Masonry11/JetRacer-Soccer-League-Year-3/Deliverables/Biweekly Reports/Biweekly_Report_Apr13.pptx

Overview

JetRacer Soccer
Jarod Marshel, Casey Rittenhouse, Arjun Simha, Mason Kang, K Gupta, Julie Ham, Cooper Ritter

Overall Project Deliverable | Progress
Basic Movement | Done
Image recognition | Done
New sensor implementation | In progress
Object following/Ball Striking | In progress
Co-op and Versus | Not started
Github with documentation | In progress
Summary and report | In progress

Project is On Schedule

Overall Concept:

New Sensor

Gantt Chart/Schedule

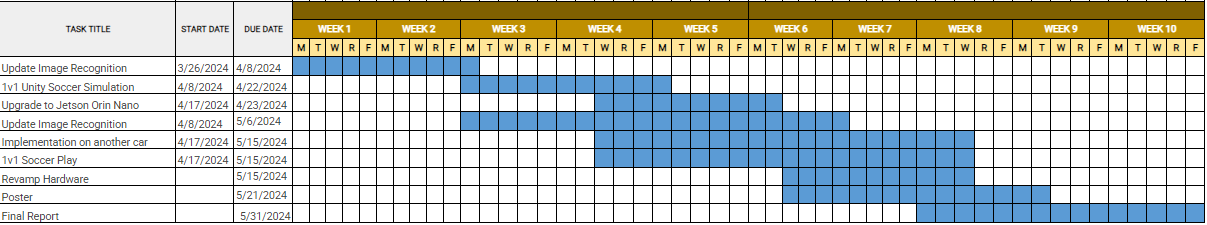
[picture p1: figure]

## Slide 2

Short-Term

JetRacer Soccer
Jarod Marshel, Casey Rittenhouse, Arjun Simha, Mason Kang, K Gupta, Julie Ham, Cooper Ritter

Previous Meeting Action Items:

Item | Description | Owner | Target Date | Status
1 | Build field for cars | Jarod | Feb 19 | Done
2 | Unity soccer simulation training | Mason | Jan 31 | Done
3 | Object following | Everyone | Mar 8 | Done
4 | Implement new sensor onto car | Everyone | Mar 11 | Done
5 | Preliminary Design Review | Everyone | Mar 12 | Done
6 | Retrain Object Detection | CV team | April 15 | In Progress
7 | 1v1 Soccer | Everyone | May 1 | Not started

Item | Description | Owner | Target Date | Status
1 | Retrain Object Detection | CV team | April 15 | In Progress
2 | 1v1 Soccer Logic | Not assigned | May 1 | Not started
3 | Set up software on cars | Casey | April 20 | In Progress
4
5

Significant Roadblocks/ Non-developing Items:

Jetson Orin
ZED SDK version conflict

Request for teaching staff:

Biweekly Action Items:

Budget:

Total Proposed | Plan to Date | Used to Date | Used Vs Plan
$3500 USD | $1450 USD | $650 USD | +$1400 USD

Apr | | | | | | | | | | Feb
11 | | | | | 16 | | | | | 21

Short Term Schedule:

Train new YOLOv8

Start upgrade to Orin

## Team Progress

## ROS (Casey and Cooper and Arjun)

JetRacer Soccer
Jarod Marshel, Casey Rittenhouse, Arjun Simha, Mason Kang, K Gupta, Julie Ham, Cooper Ritter

Previous Work:
- Determined Jetson Orin is necessary to complete desired function
- Planned versions for all necessary packages to ensure compatibility
- Looked into Docker and JetPack

Future Work:
- Purchase Jetson Orin
- Migrate current work to the Orin
- Continue to improve ROS structure
- Install Zed SDK
- Configure Docker and JetPack

## Computer Vision (K and Julie and Jarod)

JetRacer Soccer
Jarod Marshel, Casey Rittenhouse, Arjun Simha, Mason Kang, K Gupta, Julie Ham, Cooper Ritter

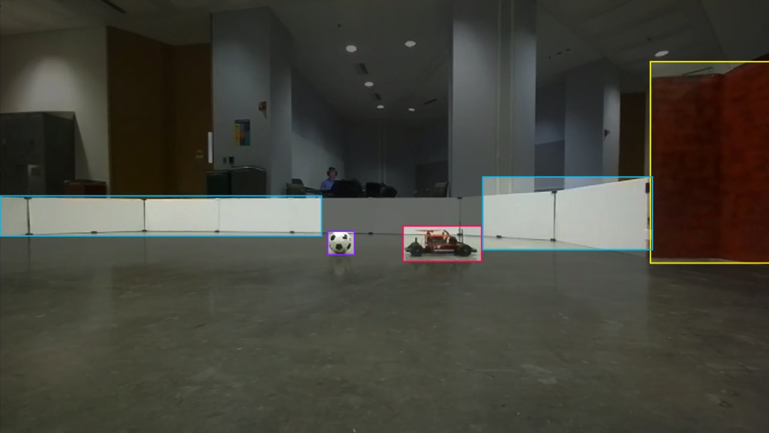
[picture p2: figure]

Previous Work:
- Annotated new dataset
- Started training weights for YOLOv8

Future Work:
- Run a YOLOv8 detection program
- Work with ROS team to set up publisher and subscriber for steering servo and ball following

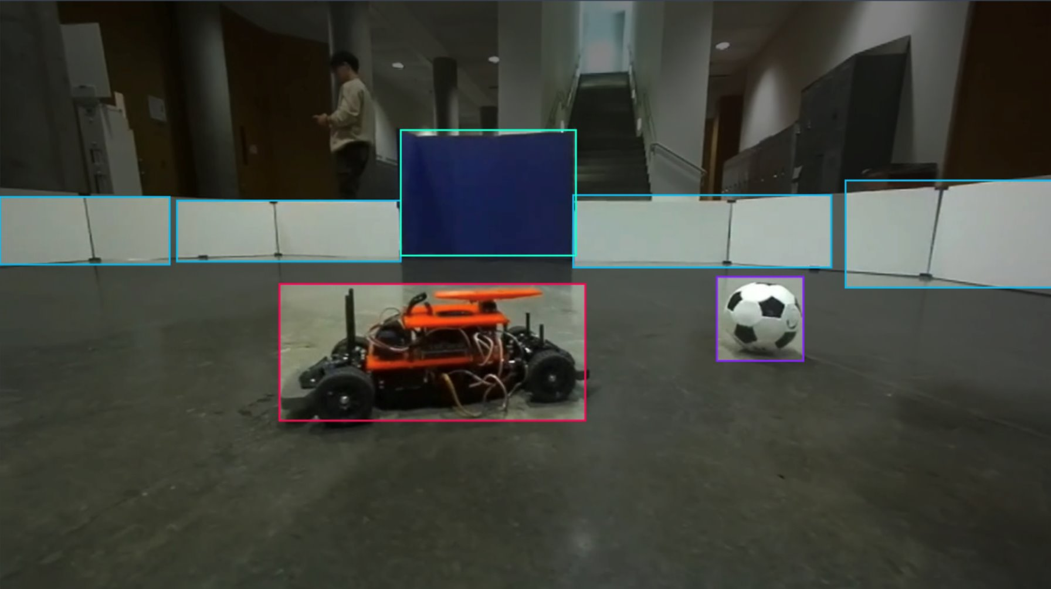
[picture p3: figure]

## Unity (Mason)

JetRacer Soccer
Jarod Marshel, Casey Rittenhouse, Arjun Simha, Mason Kang, K Gupta, Julie Ham, Cooper Ritter

Previous Work:
- Create a 3rd year repo for the JetRacer project.
- Optimize the Unity simulation as much as possible.

Future Work:
- Further document the GitHub page.
- Gather details about the Unity training and use them to prepare for the winter presentation.
