Masonry11/JetRacer-Soccer-League-Year-3/Deliverables/Biweekly Reports/Biweekly_Report_Apr27.pptx

Overview

JetRacer Soccer
Jarod Marshel, Casey Rittenhouse, Arjun Simha, Mason Kang, K Gupta, Julie Ham, Cooper Ritter

Overall Project Deliverable | Progress
Basic Movement | Done
Image recognition | Done
New sensor implementation | In progress
Object following/Ball Striking | In progress
Versus and Strategy | In progress
Github with documentation | In progress
Summary and report | In progress

Project is On Schedule

Overall Concept:

New Sensor

Gantt Chart/Schedule

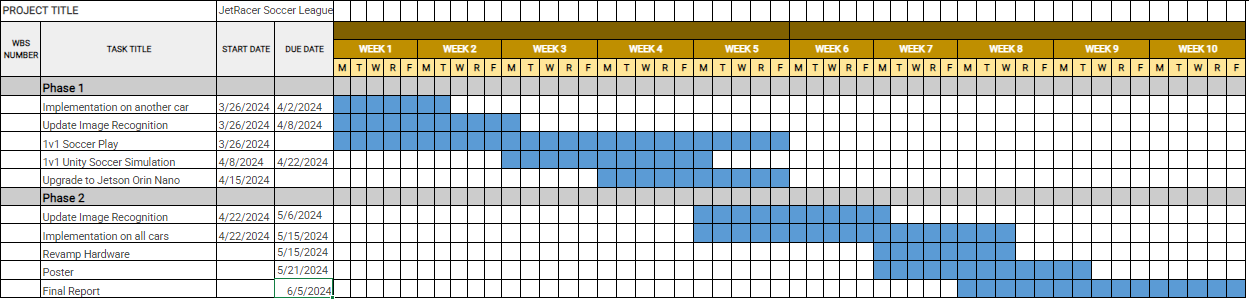
[picture p4: figure]

## Slide 2

Short-Term

JetRacer Soccer
Jarod Marshel, Casey Rittenhouse, Arjun Simha, Mason Kang, K Gupta, Julie Ham, Cooper Ritter

Previous Meeting Action Items:

Item | Description | Owner | Target Date | Status
1 | Build field for cars | Jarod | Feb 19 | Done
2 | Unity soccer simulation training | Mason | Jan 31 | Done
3 | Object following | Everyone | Mar 8 | Done
4 | Implement new sensor onto car | Everyone | Mar 11 | Done
5 | Preliminary Design Review | Everyone | Mar 12 | Done
6 | Retrain Object Detection | CV team | April 15 | In Progress
7 | 1v1 Soccer | Everyone | May 1 | Not started

Item | Description | Owner | Target Date | Status
1 | Retrain Object Detection | CV team | April 15 | In Progress
2 | 1v1 Soccer Logic | Not assigned | May 1 | Not started
3 | Set up software on cars | Casey | April 20 | In Progress
4
5

Significant Roadblocks/ Non-developing Items:

Jetson Orin conflict
ZED SDK version conflict

Request for teaching staff:

Biweekly Action Items:

Budget:

Total Proposed | Plan to Date | Used to Date | Used Vs Plan
$3500 USD | $1450 USD | $650 USD | +$1400 USD

Apr - May | | | | | | | | | | Feb
21 | | | | | 28 | | | | | 5

Short Term Schedule:

Test new YOLOV8

Start upgrade to Orin

## Team Progress

## ROS/Hardware (Cooper and Arjun)

JetRacer Soccer
Jarod Marshel, Casey Rittenhouse, Arjun Simha, Mason Kang, K Gupta, Julie Ham, Cooper Ritter

Previous Work:
- Integrated rospy with roscpp structure
- Got I2C communication (for servo control) working on Jetson
- Developed PID controller for ball tracking
- Fixed ZED calibration file issues

Future Work:
- Fine-tune ZED PID controller
  - Fix bugs
  - Improve tracking
- Implement search/scan function when ball is lost
- Print updated car parts

## CV/Image Recognition (K and Julie and Jarod)

JetRacer Soccer
Jarod Marshel, Casey Rittenhouse, Arjun Simha, Mason Kang, K Gupta, Julie Ham, Cooper Ritter


Previous Work:
- Issues running object detection with ZED on laptops- need to run on Jetson

Future Work:
- Update object recognition to include classification for blue car


## Software/Strategy (Casey and Mason)

JetRacer Soccer
Jarod Marshel, Casey Rittenhouse, Arjun Simha, Mason Kang, K Gupta, Julie Ham, Cooper Ritter

Previous Work:
- Worked on developing movement strategy
- Developed strategy for camera and steering movement
(Including basic 1v0 and ball intercepting strategy)
- Began migrating code from unity

Future Work:
- Continue to refine movement strategy
- Implement on car once hardware team is finished

## Team Roles

- Project Manager - Jarod
- Point of Contact - Arjun
- Budget Manager - Casey
- ROS/Hardware Team:
  - Cooper, Arjun,
- CV/Image Recognition Team:
  - K, Julie, Jarod
- Software/Strategy Team:
  - Casey, Mason
