Masonry11/JetRacer-Soccer-League-Year-3/Deliverables/Biweekly Reports/Biweekly_Report_Mar4.pptx

Overview

JetRacer Soccer
Jarod Marshel, Casey Rittenhouse, Arjun Simha, Mason Kang, K Gupta, Julie Ham, Cooper Ritter

Overall Project Deliverable | Progress
Basic Movement | Done
Image recognition | Done
New sensor implementation | In progress
Object following/Ball Striking | In progress
Co-op and Versus | Not started
Github with documentation | In progress
Summary and report | In progress

Project is On Schedule

Overall Concept:

New Sensor

Gantt Chart/Schedule

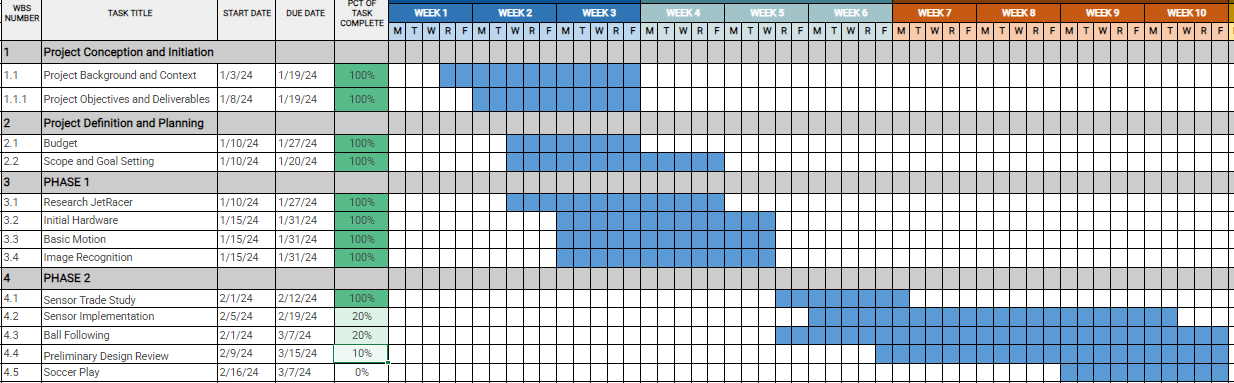
[picture p5: figure]

## Slide 2

Short-Term

JetRacer Soccer
Jarod Marshel, Casey Rittenhouse, Arjun Simha, Mason Kang, K Gupta, Julie Ham, Cooper Ritter

Previous Meeting Action Items:

Item | Description | Owner | Target Date | Status
1 | Build field for cars | Jarod | Feb 19 | Done
2 | Unity soccer simulation training | Mason | Jan 31 | Done
3 | Object following | Everyone | Mar 8 | In progress
4 | Implement new sensor onto car | Everyone | Mar 11 | In progress
5 | Preliminary Design Review | Everyone | Mar 12 | In progress
6
7

Item | Description | Owner | Target Date | Status
1 | Object following | Everyone | Mar 8 | In progress
2 | Preliminary Design Review | Everyone | Mar 12 | In progress
3 | Implement new sensor onto car | Everyone | Mar 11 | In progress
4
5

Significant Roadblocks/ Non-developing Items:

Biweekly Action Items:

Budget:

Total Proposed | Plan to Date | Used to Date | Used Vs Plan
$3500 USD | $0 USD | $0 USD | +/-$0 USD

March | | | | | | | | | | Feb
4 | | | | | 11 | 12

Short Term Schedule:

Request for teaching staff:

Get car to follow ball

Have presentation ready

## Team Progress

## ROS (Casey and Cooper)

JetRacer Soccer
Jarod Marshel, Casey Rittenhouse, Arjun Simha, Mason Kang, K Gupta, Julie Ham, Cooper Ritter

Previous Work:
- Established structure to control Zed servo
- Continued to tune movement
- Began converting ROS structure to Noetic
- Updated documentation to make ROS implementation more straightforward

Future Work:
- Work on Zed integration once CV team is ready
- Work on winter presentation and report

## LiDAR (Arjun and Jarod)

JetRacer Soccer
Jarod Marshel, Casey Rittenhouse, Arjun Simha, Mason Kang, K Gupta, Julie Ham, Cooper Ritter

Previous Work:
- Worked on putting together the winter quarter presentation documenting all of our progress and the future progress we will be working on in the spring quarter.
- Worked on putting together the design report for the winter quarter.

Future Work:
- Once ZED testing is done in winter quarter, we will work on putting together a docker container to combine all of the packages on one car to be put on the rest of the three cars.
- Need to fix up the other three cars and their parts, charge the batteries and controllers.
- Want to fully setup the full field in the ECE basement soon to see how it looks and test it with the cars and the soccer ball

## Computer Vision (K and Julie)

JetRacer Soccer
Jarod Marshel, Casey Rittenhouse, Arjun Simha, Mason Kang, K Gupta, Julie Ham, Cooper Ritter

Previous Work:
- Old camera does not work anymore – hardware issue?
  - gst_mini_object_set_qdata: assertion 'object != null' failed
  - Shift focus to ZED2
- Upgraded to Python3.8 (needed for YOLOv8)
- Trained weights for YOLOv8
- Reinstalled ZED SDK

Future Work:
- Run a YOLOv8 detection program
- Work with ROS team to set up publisher and subscriber for steering servo and ball following

## Unity (Mason)

JetRacer Soccer
Jarod Marshel, Casey Rittenhouse, Arjun Simha, Mason Kang, K Gupta, Julie Ham, Cooper Ritter

Previous Work:
- Create a 3rd year repo for the JetRacer project.
- Optimize the Unity simulation as much as possible.

Future Work:
- Furthur document the GitHub page.
- Gather details about the Unity training and use them to prepare for the winter presentation.
