Masonry11/JetRacer-Soccer-League-Year-3/Deliverables/Biweekly Reports/TA_Meet_Apr11.pptx

## Weekly Meeting 4/11/2024

JetRacer Soccer League

## Software Versions

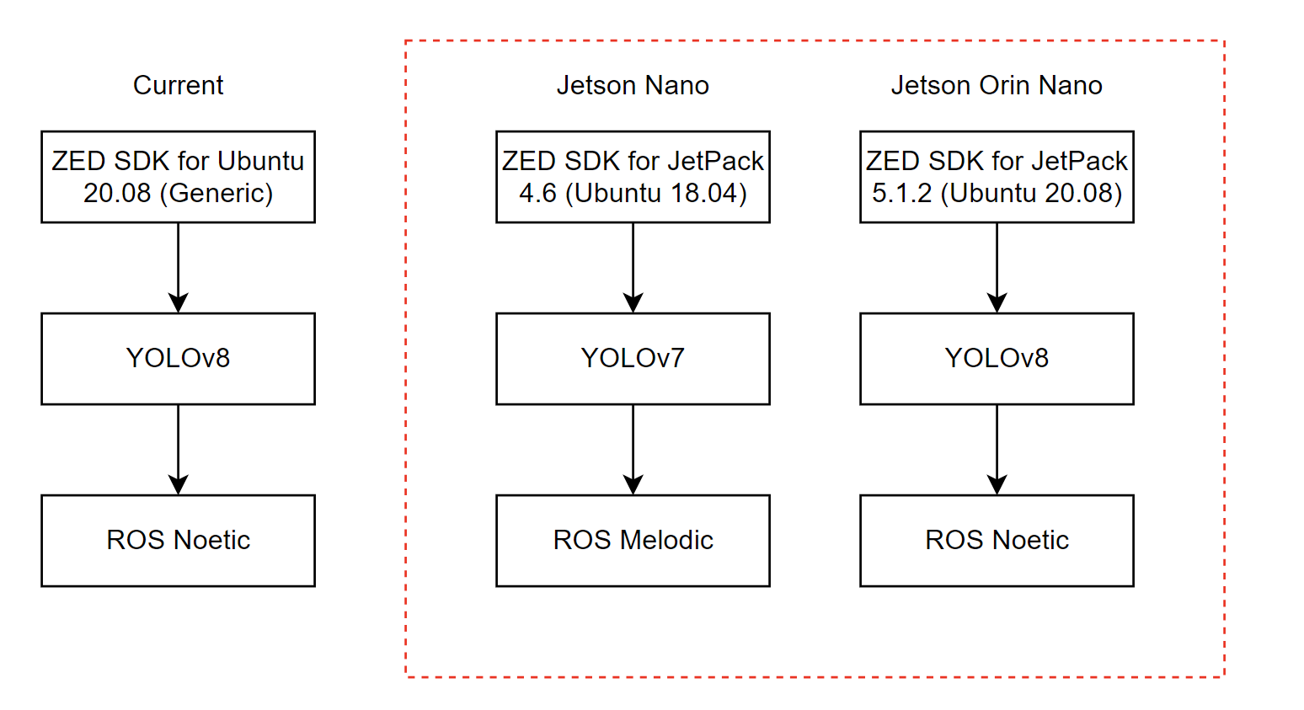
[picture p6: figure]

## ROS

Previous Work:
- Flashed SD card with Ubuntu 20.04
- Installed ROS noetic
- Attempted to install ZED 2 SDK
- Researched Docker and JetPack
- Created plan to implement Orin Nano

Future Work:
- Continue to work with ZED SDK
- Use Docker containers for package management
- Purchase and install Orin Nano

## CV

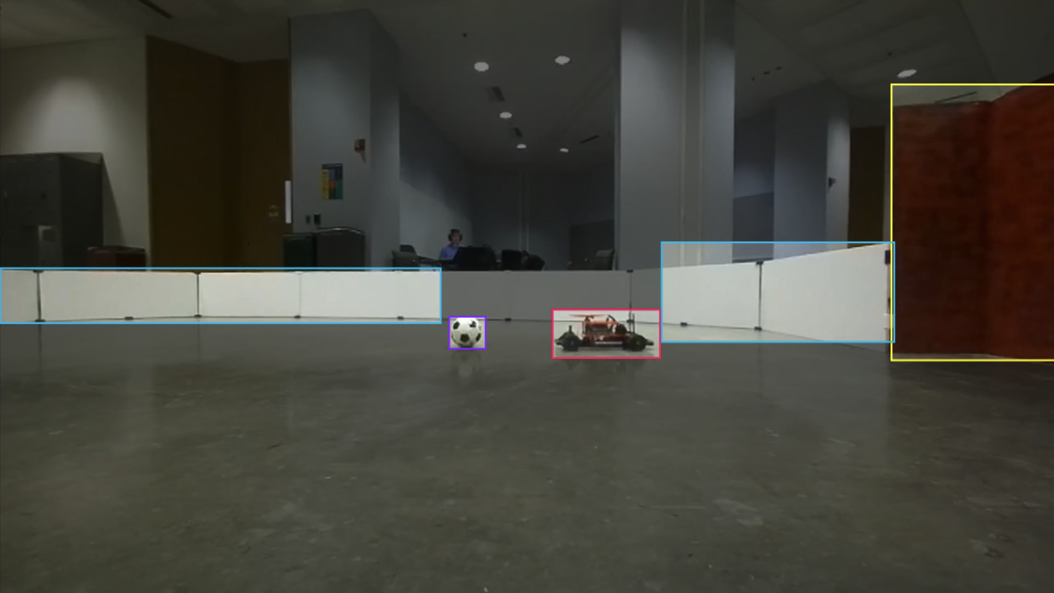
[picture p7: figure]

Previous work:
- Annotated the 660 photos on the dataset and started training the dataset.

Future work:
- Test out new CV with yolov8 and check if object detection needs more training
- Record more videos and annotate more pictures with the blue car

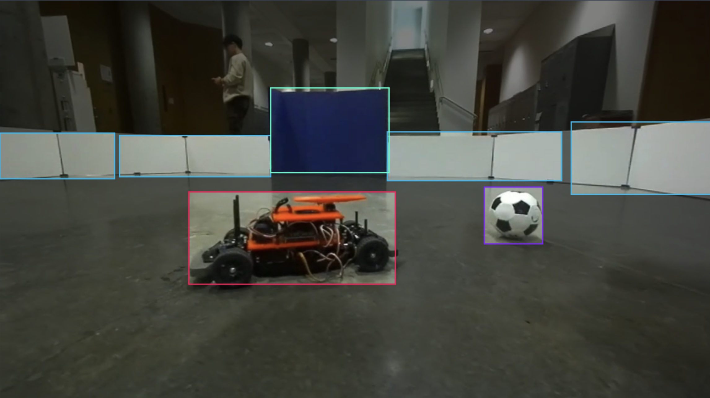
[picture p8: figure]

## Red Car

- Current:
  - Red 3D printed mounts and servo motor
  - ZED
- Future:
  - Jetson Orin Nano

Blue Car

- Current:
  - No hardware
- Future:
  - Jetson Orin Nano
  - ZED
  - Blue 3D printed mounts and servo motor
  - Need to record video and annotate dataset
