Masonry11/JetRacer-Soccer-League-Year-3/Deliverables/Biweekly Reports/TA_Meet_Apr18.pptx

## Weekly Meeting 4/18/2024

JetRacer Soccer League

## ROS/Hardware

Previous Work:
- Flashed SD card with Jetpack 5.2.1 (Ubuntu 20.04)
- Setup ZED 2 SDK & ROS Noetic
- Researched creating ISO/image for cloning packages/OS
- Configured jetracer package
- Updated CAD with Orin

Future Work:
- Create disk ISO
- Re-implement servo/motor control
- Create PID controller for camera swivel
- Utilize SDK for intelligent movement

## Movement Strategy

- Began planning robot movement from CV outputs
- Worked on determining movement strategy based on unity model

- Continue to generate movement strategy
- Determine method of angle and speed calculation with minimum latency

## CV

Previous work:
- Finished training with new dataset

Future work:
- Test out new CV with yolov8 and check if object detection needs more training
- Record more videos and annotate more pictures with the blue car

## CV

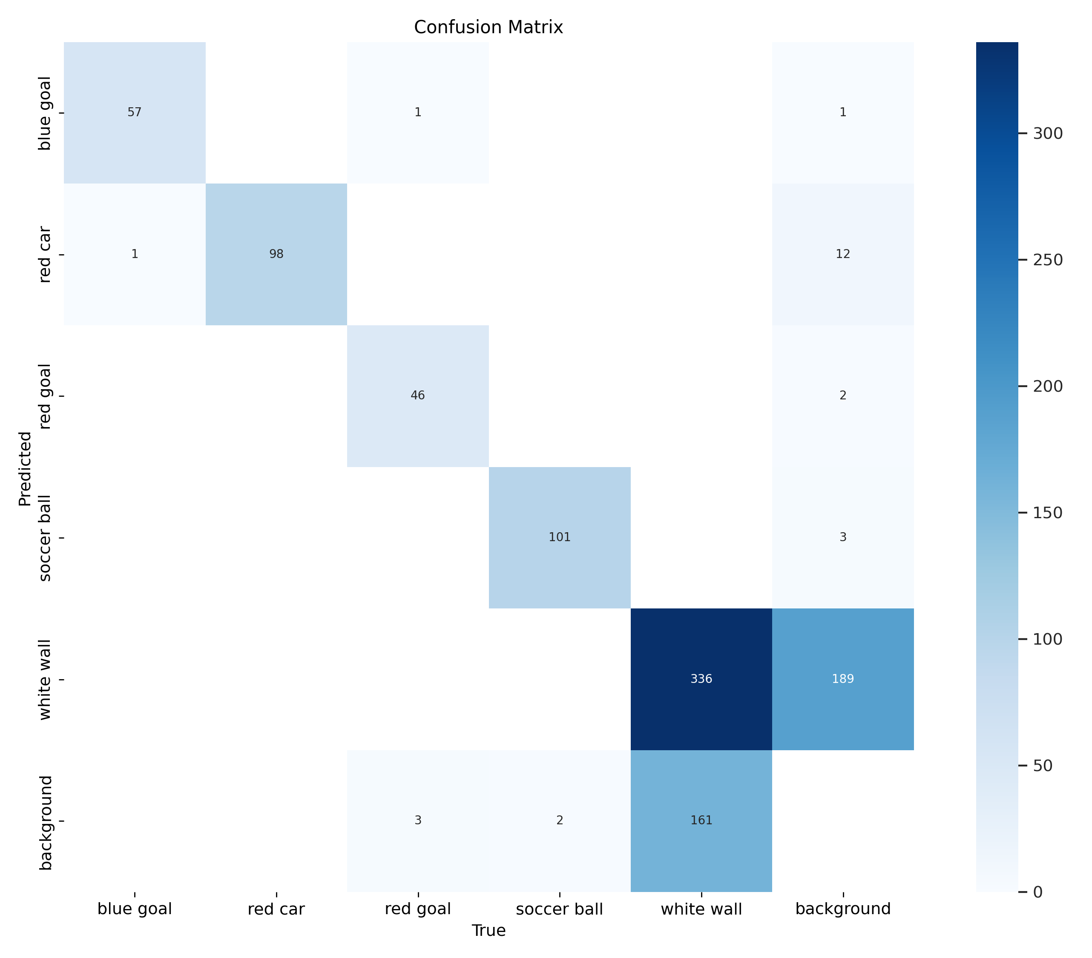
[picture p9: figure]

## CV

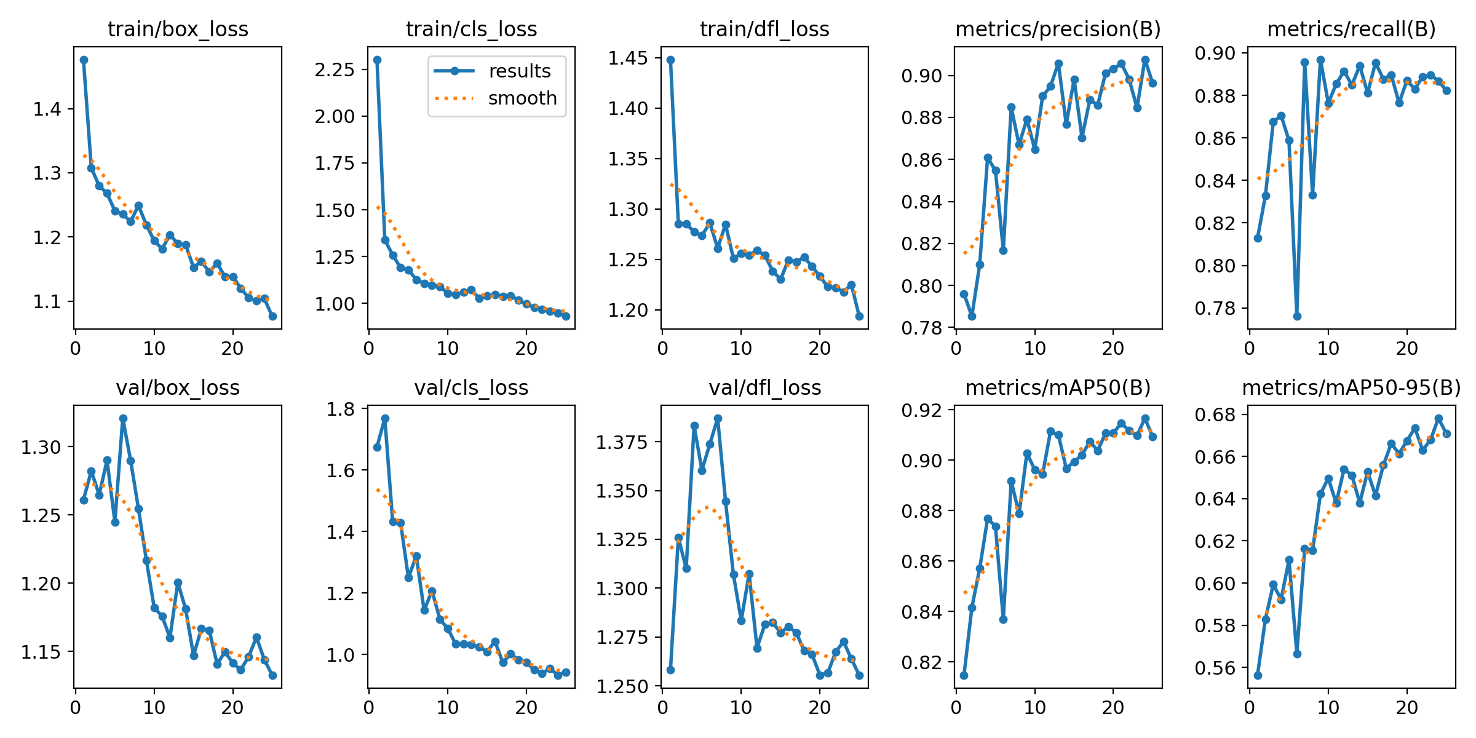
[picture p10: figure]
