Masonry11/JetRacer-Soccer-League-Year-3/Deliverables/Biweekly Reports/TA_Meet_May17.pptx

## Weekly Meeting 5/17/2024

JetRacer Soccer League

## ROS/Hardware

Previous Work:
- Finished ROS groundwork
- Completed ZED2 camera swivel script
- Started printing chassis

Future Work:
- Implement movement strategy
- Import custom dataset
- Assemble car's upon print finish

## Movement Strategy

- Continue planning robot movement from CV outputs
- Continued development of more complex striking
- Tested ZED distance accuracy

- Test state transitions
- Determine method of angle and speed calculation with minimum latency
- Improve striking

## Slide 4

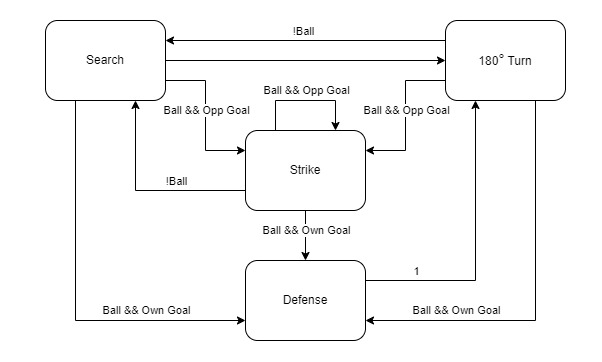
[picture p12: figure]

## Slide 5

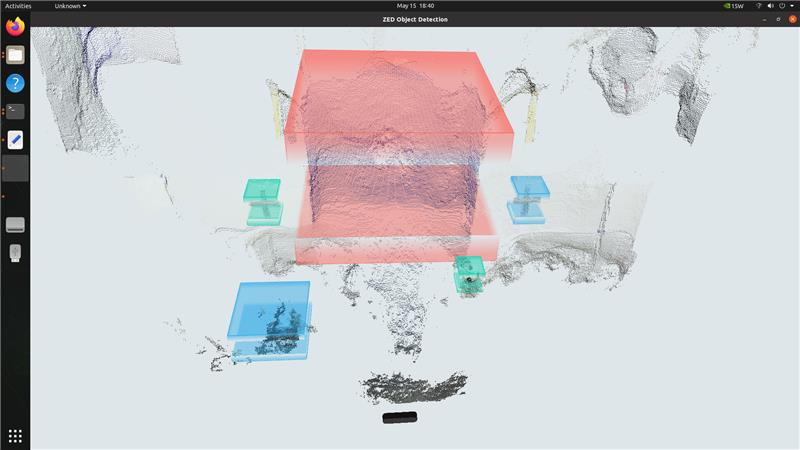
[picture p13: figure]

## Slide 6

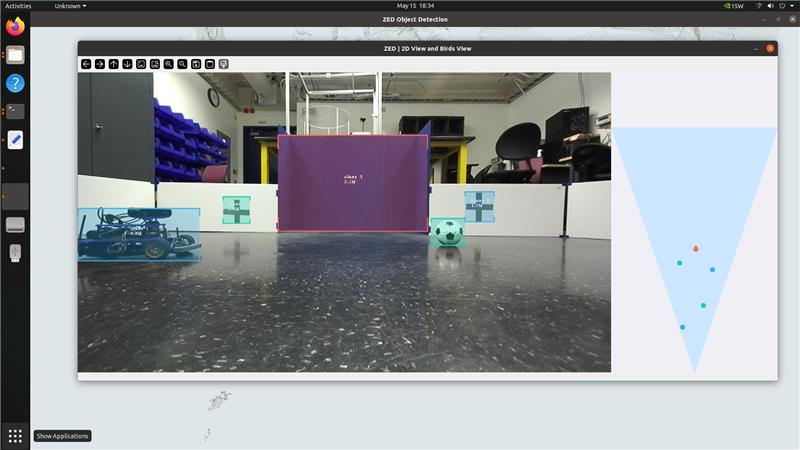
[picture p14: figure]

## Slide 7

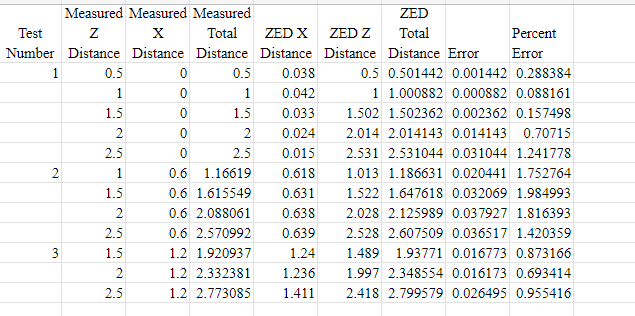
[picture p15: figure]

## CV

Previous work:
- Concluded primary work of CV which was to get a functional model running on the cars to provide perception inputs
- Transitioning to other work items

Future work:
- Work on implementing everything onto all cars
- Update Github documentation
