Masonry11/JetRacer-Soccer-League-Year-3/Deliverables/Biweekly Reports/TA_Meet_Apr41.pptx

## Weekly Meeting 4/4/2024

JetRacer Soccer League

## ROS

Previous Work:
- Flashed SD card with Ubuntu 20.04
- Installed ROS noetic
- Attempted to install ZED 2 SDK
- Researched Docker and JetPack

Future Work:
- Continue to work with ZED SDK
- Use Docker containers for package management

## CV

Previous work:
- Recorded videos for new image dataset with zed2 (720p 60fps)
- Spray painted goal to have red and blue goals
- Issue with driving car with controller – resolved by changing wiring on mux

Future work:
- Annotate dataset in Roboflow
- Train model on new dataset
- Reimplement object detection/following with new model
