Masonry11/JetRacer-Soccer-League-Year-3/Deliverables/Biweekly Reports/Spring_Gantt_Chart.xlsx

GANTT CHART
PROJECT TITLE |  | JetRacer Soccer League
WBS NUMBER | TASK TITLE | START DATE | DUE DATE
 |  |  |  | WEEK 1
 |  |  |  | M | T | W | R
1.1 | Project Background and Context | 2024-01-03 | 2024-01-19
1.1.1 | Project Objectives and Deliverables | 2024-01-08 | 2024-01-19
2.1 | Budget | 2024-01-10 | 2024-01-20
2.2 | Scope and Goal Setting | 2024-01-10 | 2024-01-27
3.1 | Research JetRacer | 2024-01-10 | 2024-01-27
3.2 | Initial Hardware | 2024-01-15 | 2024-01-31
3.3 | Basic Motion | 2024-01-15 | 2024-01-31
3.4 | Image Recognition | 2024-01-15 | 2024-01-31
4.1 | Sensor Trade Study | 2024-02-01 | 2024-02-12
4.2 | Sensor Implementation | 2024-02-05 | 2024-02-19
4.3 | Ball Following | 2024-02-01 | 2024-03-07
4.4 | Preliminary Design Review | 2024-02-26 | 2024-03-15
4.5 | Soccer Play | 2024-02-26 | 2024-03-15
4.6
 | Phase 1
 | Implementation on another car | 2024-03-26 | 2024-04-02
 | Update Image Recognition | 2024-03-26 | 2024-04-08
 | 1v1 Soccer Play | 2024-03-26
 | 1v1 Unity Soccer Simulation | 2024-04-08 | 2024-04-22
 | Upgrade to Jetson Orin Nano | 2024-04-15
 | Phase 2
 | Update Image Recognition | 2024-04-22 | 2024-05-06
 | Implementation on all cars | 2024-04-22 | 2024-05-15
 | Revamp Hardware |  | 2024-05-15
 | Poster |  | 2024-05-21
 | Final Report |  | 2024-06-05
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
