Masonry11/JetRacer-Soccer-League-Year-3/Deliverables/Biweekly Reports/Winter_Gantt_Chart.xlsx

GANTT CHART
PROJECT TITLE |  | JetRacer Soccer League |  |  | COMPANY NAME |  |  |  |  |  |  | Lockheed Martin
WBS NUMBER | TASK TITLE | START DATE | DUE DATE | PCT OF TASK COMPLETE | PHASE ONE |  |  |  |  |  |  |  |  |  |  |  |  |  |  | PHASE TWO |  |  |  |  |  |  |  |  |  |  |  |  |  |  | PHASE THREE |  |  |  |  |  |  |  |  |  |  |  |  |  |  |  |  |  |  |  | PHASE FOUR
 |  |  |  |  | WEEK 1 |  |  |  |  | WEEK 2 |  |  |  |  | WEEK 3 |  |  |  |  | WEEK 4 |  |  |  |  | WEEK 5 |  |  |  |  | WEEK 6 |  |  |  |  | WEEK 7 |  |  |  |  | WEEK 8 |  |  |  |  | WEEK 9 |  |  |  |  | WEEK 10 |  |  |  |  | WEEK 11
 |  |  |  |  | M | T | W | R | F | M | T | W | R | F | M | T | W | R | F | M | T | W | R | F | M | T | W | R | F | M | T | W | R | F | M | T | W | R | F | M | T | W | R | F | M | T | W | R | F | M | T | W | R | F | M | T | W | R
1 | Project Conception and Initiation
1.1 | Project Background and Context | 2024-01-03 | 2024-01-19 | 100%
1.1.1 | Project Objectives and Deliverables | 2024-01-08 | 2024-01-19 | 100%
2 | Project Definition and Planning
2.1 | Budget | 2024-01-10 | 2024-01-20 | 100%
2.2 | Scope and Goal Setting | 2024-01-10 | 2024-01-27 | 100%
3 | PHASE 1
3.1 | Research JetRacer | 2024-01-10 | 2024-01-27 | 100%
3.2 | Initial Hardware | 2024-01-15 | 2024-01-31 | 100%
3.3 | Basic Motion | 2024-01-15 | 2024-01-31 | 100%
3.4 | Image Recognition | 2024-01-15 | 2024-01-31 | 100%
4 | PHASE 2
4.1 | Sensor Trade Study | 2024-02-01 | 2024-02-12 | 100%
4.2 | Sensor Implementation | 2024-02-05 | 2024-03-07 | 100%
4.3 | Ball Following | 2024-02-01 | 2024-03-07 | 100%
4.4 | Preliminary Design Review | 2024-02-26 | 2024-03-15 | 100%
4.6
4.5 | Soccer Play | 2024-02-26 | 2024-03-15 | 10%
5 | PHASE 3 (Spring)
5.1
5.2
5.3
5.4
5.5
6 | PHASE 4
6.1
6.2
6.3
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
