Masonry11/JetRacer-Soccer-League-Year-3/CAD/STEP/tamiya_chassis.stp

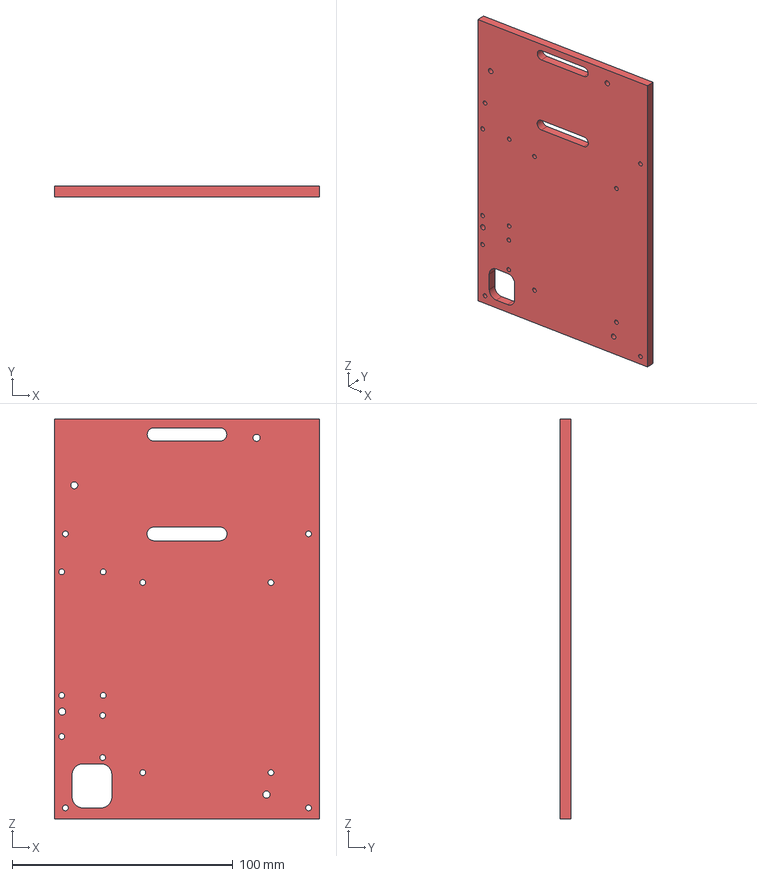
[picture p66: CAD file, 2024-05-28]
CAD/STEP/tamiya_chassis.stp
120.0 x 5.00 x 181.0 mm
