Masonry11/JetRacer-Soccer-League-Year-3/CAD/STEP/top_plate.stp

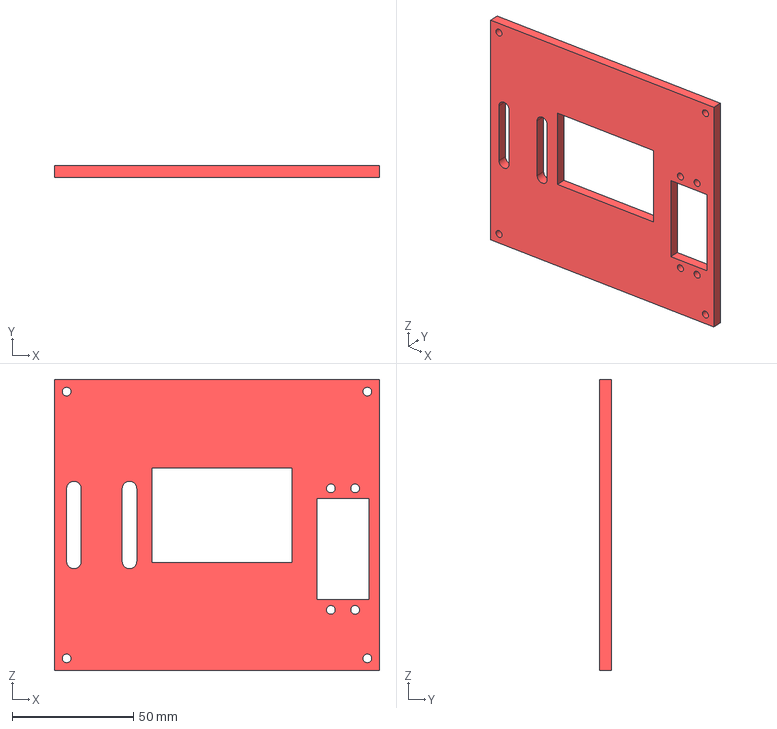
[picture p67: CAD file, 2024-05-28]
CAD/STEP/top_plate.stp
134.0 x 5.00 x 120.0 mm
