Masonry11/JetRacer-Soccer-League-Year-3/(list of files, cad)

Other CAD files:
CAD/JetRacer/Templates/English/ANSI (in).dwg
CAD/JetRacer/Templates/Metric/ANSI (mm).dwg
CAD/JetRacer/Templates/Standard.dwg
CAD/JetRacer/Templates/Metric/ISO.dwg
CAD/JetRacer/Templates/Metric/GOST.dwg
CAD/JetRacer/Templates/Metric/DIN.dwg
CAD/JetRacer/Templates/Metric/JIS.dwg
CAD/JetRacer/Templates/Metric/BSI.dwg
CAD/JetRacer/Templates/Metric/GB.dwg
CAD/JetRacer/Design Data/AIT/Mold Design/mold design stop pin.ipt
CAD/JetRacer/Design Data/Cable & Harness/en-US/harness.iam
CAD/JetRacer/Design Data/Tube & Pipe/en-US/piping runs.iam
CAD/JetRacer/Templates/English/ANSI (in).idw
CAD/JetRacer/Templates/English/Mold Design (in).iam
CAD/JetRacer/Templates/English/Sheet Metal (in).ipt
CAD/JetRacer/Templates/English/Standard (in).iam
CAD/JetRacer/Templates/English/Standard (in).ipn
CAD/JetRacer/Templates/English/Standard (in).ipt
CAD/JetRacer/Templates/English/Weldment (ANSI).iam
CAD/JetRacer/Templates/Metric/ANSI (mm).idw
CAD/JetRacer/Templates/Metric/BSI.idw
CAD/JetRacer/Templates/Metric/DIN.idw
CAD/JetRacer/Templates/Metric/GB.idw
CAD/JetRacer/Templates/Metric/GOST.idw
CAD/JetRacer/Templates/Metric/ISO.idw
CAD/JetRacer/Templates/Metric/JIS.idw
CAD/JetRacer/Templates/Metric/Mold Design (DIN).iam
CAD/JetRacer/Templates/Metric/Mold Design (mm).iam
CAD/JetRacer/Templates/Metric/Sheet Metal (DIN).ipt
CAD/JetRacer/Templates/Metric/Sheet Metal (mm).ipt
CAD/JetRacer/Templates/Metric/Standard (DIN).iam
CAD/JetRacer/Templates/Metric/Standard (DIN).ipn
CAD/JetRacer/Templates/Metric/Standard (DIN).ipt
CAD/JetRacer/Templates/Metric/Standard (mm).iam
CAD/JetRacer/Templates/Metric/Standard (mm).ipn
CAD/JetRacer/Templates/Metric/Standard (mm).ipt
CAD/JetRacer/Templates/Metric/Weldment (ANSI - mm).iam
CAD/JetRacer/Templates/Metric/Weldment (BSI).iam
CAD/JetRacer/Templates/Metric/Weldment (DIN).iam
CAD/JetRacer/Templates/Metric/Weldment (GB).iam
CAD/JetRacer/Templates/Metric/Weldment (ISO).iam
CAD/JetRacer/Templates/Metric/Weldment (JIS).iam
CAD/JetRacer/Templates/Mold Design/Mold Design.iam
CAD/JetRacer/Templates/Sheet Metal.ipt
CAD/JetRacer/Templates/Standard.iam
CAD/JetRacer/Templates/Standard.idw
CAD/JetRacer/Templates/Standard.ipn
CAD/JetRacer/Templates/Standard.ipt
CAD/JetRacer/Templates/Weldment.iam
CAD/JetRacer/Workgroups/NotInProject/032-0681-000_1.ipt
CAD/JetRacer/Workgroups/NotInProject/032-0696-000_1.ipt
CAD/JetRacer/Workgroups/NotInProject/032-0796-000_1.ipt
CAD/JetRacer/Workgroups/NotInProject/0402_H040.ipt
CAD/JetRacer/Workgroups/NotInProject/0402_H060.ipt
CAD/JetRacer/Workgroups/NotInProject/0603_H060.ipt
CAD/JetRacer/Workgroups/NotInProject/0603_H100.ipt
CAD/JetRacer/Workgroups/NotInProject/064-0267-000_1.ipt
CAD/JetRacer/Workgroups/NotInProject/064-0404-000_1.ipt
CAD/JetRacer/Workgroups/NotInProject/064-0437-000_1.ipt
CAD/JetRacer/Workgroups/NotInProject/074-0221-000_3.ipt
CAD/JetRacer/Workgroups/NotInProject/074-0239-000_1.ipt
CAD/JetRacer/Workgroups/NotInProject/080-1243-000_3.ipt
CAD/JetRacer/Workgroups/NotInProject/080-1263-000_1_OBSOLETE.ipt
CAD/JetRacer/Workgroups/NotInProject/080-1263-000_2.ipt
CAD/JetRacer/Workgroups/NotInProject/080-1483-000_2.ipt
CAD/JetRacer/Workgroups/NotInProject/080-1655-000_3.ipt
CAD/JetRacer/Workgroups/NotInProject/080-1656-000_3.ipt
CAD/JetRacer/Workgroups/NotInProject/080-1890-000_1.ipt
CAD/JetRacer/Workgroups/NotInProject/080-1898-000_1.ipt
CAD/JetRacer/Workgroups/NotInProject/080-2191-000_1.ipt
CAD/JetRacer/Workgroups/NotInProject/0805_H140.ipt
CAD/JetRacer/Workgroups/NotInProject/0805_H150.ipt
CAD/JetRacer/Workgroups/NotInProject/0805_H160.ipt
CAD/JetRacer/Workgroups/NotInProject/085-0347-000_1.ipt
CAD/JetRacer/Workgroups/NotInProject/086-0311-000_1.ipt
CAD/JetRacer/Workgroups/NotInProject/090-0155-000_1.ipt
CAD/JetRacer/Workgroups/NotInProject/090-0172-000_1.ipt
CAD/JetRacer/Workgroups/NotInProject/090-0243-000_1.ipt
CAD/JetRacer/Workgroups/NotInProject/090-0296-000_2.ipt
CAD/JetRacer/Workgroups/NotInProject/090-0343-000_1.ipt
CAD/JetRacer/Workgroups/NotInProject/090-0377-000_1.ipt
CAD/JetRacer/Workgroups/NotInProject/090-0378-000_1.ipt
CAD/JetRacer/Workgroups/NotInProject/091-0022-000_1.ipt
CAD/JetRacer/Workgroups/NotInProject/092-0073-000_1.ipt
CAD/JetRacer/Workgroups/NotInProject/095-0180-000-TS1.ipt
CAD/JetRacer/Workgroups/NotInProject/095-0180-000-TS1_ASM.iam
CAD/JetRacer/Workgroups/NotInProject/115-0085-000_1.ipt
CAD/JetRacer/Workgroups/NotInProject/115-0138-000_1.ipt
CAD/JetRacer/Workgroups/NotInProject/115-0655-000_3.ipt
CAD/JetRacer/Workgroups/NotInProject/115-1921-000_3.ipt
CAD/JetRacer/Workgroups/NotInProject/115-2177-000_2.ipt
CAD/JetRacer/Workgroups/NotInProject/115-2544-000_1.ipt
CAD/JetRacer/Workgroups/NotInProject/115-2747-000_1.ipt
CAD/JetRacer/Workgroups/NotInProject/115-2766-000_1.ipt
CAD/JetRacer/Workgroups/NotInProject/115-2791-000_1.ipt
CAD/JetRacer/Workgroups/NotInProject/115-2838-000_1.ipt
CAD/JetRacer/Workgroups/NotInProject/115-3110-000_1.ipt
CAD/JetRacer/Workgroups/NotInProject/1206_H180.ipt
CAD/JetRacer/Workgroups/NotInProject/130-1221-000_1.ipt
CAD/JetRacer/Workgroups/NotInProject/130-1404-000_1.ipt
CAD/JetRacer/Workgroups/NotInProject/142-13526-1000-A01-SKU0000.ipt
CAD/JetRacer/Workgroups/NotInProject/142-13526-1000-A01-SKU0000_ASM.iam
CAD/JetRacer/Workgroups/NotInProject/155-0576-000.ipt
CAD/JetRacer/Workgroups/NotInProject/155-0697-000_2_AF0.ipt
CAD/JetRacer/Workgroups/NotInProject/155-0697-000_2_AF1.ipt
CAD/JetRacer/Workgroups/NotInProject/155-0697-000_2_AF2.ipt
CAD/JetRacer/Workgroups/NotInProject/155-0899-000.ipt
CAD/JetRacer/Workgroups/NotInProject/155-0901-000.ipt
CAD/JetRacer/Workgroups/NotInProject/155-GROGU-000.ipt
CAD/JetRacer/Workgroups/NotInProject/174-0159-000_2.ipt
CAD/JetRacer/Workgroups/NotInProject/195-3883-000_1.ipt
CAD/JetRacer/Workgroups/NotInProject/300-0518-000_1.ipt
CAD/JetRacer/Workgroups/NotInProject/300-0859-000_1.ipt
CAD/JetRacer/Workgroups/NotInProject/300-0868-000_3.ipt
CAD/JetRacer/Workgroups/NotInProject/300-0906-000_1.ipt
CAD/JetRacer/Workgroups/NotInProject/300-1070-000_3.ipt
CAD/JetRacer/Workgroups/NotInProject/300-1133-000_1.ipt
CAD/JetRacer/Workgroups/NotInProject/300-1185-000_1.ipt
CAD/JetRacer/Workgroups/NotInProject/300-1253-000_1.ipt
CAD/JetRacer/Workgroups/NotInProject/300-1278-000_1.ipt
CAD/JetRacer/Workgroups/NotInProject/315-0992-000_1.ipt
CAD/JetRacer/Workgroups/NotInProject/315-1022-000_1.ipt
CAD/JetRacer/Workgroups/NotInProject/316-0538-000_1.ipt
CAD/JetRacer/Workgroups/NotInProject/316-0703-000_1.ipt
CAD/JetRacer/Workgroups/NotInProject/320-1004-000_2.ipt
CAD/JetRacer/Workgroups/NotInProject/330-0266-000_M2_WIFI_MODULE_ASM.iam
CAD/JetRacer/Workgroups/NotInProject/330-0266-000_MODULE_BOARD.ipt
CAD/JetRacer/Workgroups/NotInProject/3514-IMPELLER-J441-346-2_6.ipt
CAD/JetRacer/Workgroups/NotInProject/3514_18.ipt
CAD/JetRacer/Workgroups/NotInProject/3514_ASM_1112_ASM.iam
CAD/JetRacer/Workgroups/NotInProject/3514_ASM_2_ASM.iam
CAD/JetRacer/Workgroups/NotInProject/375-0137-000.ipt
CAD/JetRacer/Workgroups/NotInProject/600-13768-0000-A04.ipt
CAD/JetRacer/Workgroups/NotInProject/BGA234_055_750X1050_1.ipt
CAD/JetRacer/Workgroups/NotInProject/C0201_1.ipt
CAD/JetRacer/Workgroups/NotInProject/C0402_1XX.ipt
CAD/JetRacer/Workgroups/NotInProject/COAXIAL_CABLE_WIFI_LEFT_P3526.ipt
CAD/JetRacer/Workgroups/NotInProject/COAXIAL_CABLE_WIFI_P3526.ipt
CAD/JetRacer/Workgroups/NotInProject/DFN2X2-8_1.ipt
CAD/JetRacer/Workgroups/NotInProject/FID_40_80SM.ipt
CAD/JetRacer/Workgroups/NotInProject/GROGU_MODULE_BOARD_ME.ipt
CAD/JetRacer/Workgroups/NotInProject/LEAFSPRING-P3767-CG.ipt
CAD/JetRacer/Workgroups/NotInProject/LL_VENDOR_DATECODE_TOP_SML.ipt
CAD/JetRacer/Workgroups/NotInProject/LOGO_LABEL_699_PPID_0050X0050.ipt
CAD/JetRacer/Workgroups/NotInProject/LOGO_LABEL_PPID_0180X0050.ipt
CAD/JetRacer/Workgroups/NotInProject/LOGO_SILK_180_I560.ipt
CAD/JetRacer/Workgroups/NotInProject/LOGO_SILK_HF_I0185X0120.ipt
CAD/JetRacer/Workgroups/NotInProject/LTPT025C.ipt
CAD/JetRacer/Workgroups/NotInProject/LTPT071C125D.ipt
CAD/JetRacer/Workgroups/NotInProject/LTPT089C125D.ipt
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
