Masonry11/JetRacer-Soccer-League-Year-3/ROS Package/jetracer_direct/scripts/detector.py

#!/usr/bin/env python3

import sys
import numpy as np
import math

import rospy
from jetracer_direct.msg import objects_stamped_msg, objects_msg

import argparse
import torch
import pyzed.sl as sl
import cv2
from ultralytics import YOLO

from threading import Lock, Thread
from time import *

lock = Lock()
run_signal = False
exit_signal = False
timeout_limit = rospy.get_param("/timeout_limit")

def xywh2abcd(xywh, im_shape):
    output = np.zeros((4, 2))

    # Center / Width / Height -> BBox corners coordinates
    x_min = (xywh[0] - 0.5*xywh[2]) #* im_shape[1]
    x_max = (xywh[0] + 0.5*xywh[2]) #* im_shape[1]
    y_min = (xywh[1] - 0.5*xywh[3]) #* im_shape[0]
    y_max = (xywh[1] + 0.5*xywh[3]) #* im_shape[0]

    # A ------ B
    # | Object |
    # D ------ C

    output[0][0] = x_min
    output[0][1] = y_min

    output[1][0] = x_max
    output[1][1] = y_min

    output[2][0] = x_max
    output[2][1] = y_max

    output[3][0] = x_min
    output[3][1] = y_max
    return output

def detections_to_custom_box(detections, im0):
    output = []
    for i, det in enumerate(detections):
        xywh = det.xywh[0]

        # Creating ingestable objects for the ZED SDK
        obj = sl.CustomBoxObjectData()
        obj.bounding_box_2d = xywh2abcd(xywh, im0.shape)
        obj.label = det.cls
        obj.probability = det.conf
        obj.is_grounded = False
        output.append(obj)
    return output


def torch_thread(weights, img_size, conf_thres=0.2, iou_thres=0.45):
    global image_net, run_signal, detections
    
    # Check for CUDA device and set it
    device = 'cuda' if torch.cuda.is_available() else 'cpu'
    print(f'Using device: {device}')
    print("Intializing Network...")

    model = YOLO(weights).to(device)

    while not rospy.is_shutdown():
        if run_signal:
            lock.acquire()

            img = cv2.cvtColor(image_net, cv2.COLOR_BGRA2RGB)
            # https://docs.ultralytics.com/modes/predict/#video-suffixes
            det = model.predict(img, save=False, imgsz=img_size, conf=conf_thres, iou=iou_thres)[0].cpu().numpy().boxes

            # ZED CustomBox format (with inverse letterboxing tf applied)
            detections = detections_to_custom_box(det, image_net)
            lock.release()
            run_signal = False
        sleep(0.01)

def main():
    rospy.init_node('detector', anonymous=True)
    pub = rospy.Publisher('objects_stamped_msg', objects_stamped_msg, queue_size=0)

    global image_net, exit_signal, run_signal, detections

    capture_thread = Thread(target=torch_thread, kwargs={'weights': opt.weights, 'img_size': opt.img_size, "conf_thres": opt.conf_thres})
    capture_thread.start()

    print("Initializing Camera...")

    zed = sl.Camera()

    input_type = sl.InputType()
    if opt.svo is not None:
        input_type.set_from_svo_file(opt.svo)

    # Create a InitParameters object and set configuration parameters
    init_params = sl.InitParameters(input_t=input_type, svo_real_time_mode=True)
    init_params.coordinate_units = sl.UNIT.METER
    init_params.depth_mode = sl.DEPTH_MODE.ULTRA  # ULTRA
    init_params.coordinate_system = sl.COORDINATE_SYSTEM.RIGHT_HANDED_Z_UP_X_FWD
    init_params.depth_maximum_distance = 5
    init_params.camera_resolution = sl.RESOLUTION.HD720
    init_params.camera_fps = 30

    runtime_params = sl.RuntimeParameters()
    status = zed.open(init_params)

    if status != sl.ERROR_CODE.SUCCESS:
        print(repr(status))
        exit()

    image_left_tmp = sl.Mat()

    print("Initialized Camera")

    positional_tracking_parameters = sl.PositionalTrackingParameters()
    # If the camera is static, uncomment the following line to have better performances and boxes sticked to the ground.
    # positional_tracking_parameters.set_as_static = True
    zed.enable_positional_tracking(positional_tracking_parameters)

    obj_param = sl.ObjectDetectionParameters()
    obj_param.detection_model = sl.OBJECT_DETECTION_MODEL.CUSTOM_BOX_OBJECTS
    obj_param.enable_tracking = True
    zed.enable_object_detection(obj_param)

    objects = sl.Objects()
    obj_runtime_param = sl.ObjectDetectionRuntimeParameters()

    objects_seen = {}
    while not rospy.is_shutdown():
        if zed.grab(runtime_params) == sl.ERROR_CODE.SUCCESS:
            # -- Get the image
            lock.acquire()
            zed.retrieve_image(image_left_tmp, sl.VIEW.LEFT)
            image_net = image_left_tmp.get_data()
            lock.release()
            run_signal = True

            # -- Detection running on the other thread
            while run_signal and not rospy.is_shutdown():
                sleep(0.001)

            # Wait for detections
            lock.acquire()
            # -- Ingest detections
            zed.ingest_custom_box_objects(detections)
            lock.release()
            zed.retrieve_objects(objects, obj_runtime_param)

            obj_array = objects.object_list
            #print(str(len(obj_array)) + " Object(s) detected\n")
            objects_stamped = []
            for object in obj_array:
                o_msg = objects_msg()
                o_msg.label = str(object.raw_label)
                o_msg.position = object.position
                o_msg.distance = math.sqrt((object.position[0]**2) + (object.position[1]**2))
                o_msg.center = (object.bounding_box_2d[0][0] + object.bounding_box_2d[1][0])/2
                objects_stamped.append(o_msg)
                
                objects_seen[str(object.raw_label)] = 5

            recent_objects = []
            for label, count in objects_seen.items():
                if (count > 0):
                    objects_seen[label] = count - 1
                    recent_objects.append(label)

            os_msg = objects_stamped_msg()
            os_msg.objects = objects_stamped
            os_msg.recent_objects = recent_objects
            pub.publish(os_msg)
    zed.close()

if __name__ == '__main__':
    parser = argparse.ArgumentParser()
    parser.add_argument('--weights', type=str, default='/home/jetracer/catkin_ws/src/jetracer_direct/weights/best.pt', help='model.pt path(s)')
    parser.add_argument('--svo', type=str, default=None, help='optional svo file')
    parser.add_argument('--img_size', type=int, default=416, help='inference size (pixels)')
    parser.add_argument('--conf_thres', type=float, default=0.4, help='object confidence threshold')
    opt, unknown = parser.parse_known_args() #opt = parser.parse_args()

    with torch.no_grad():
        main()
